kevinraymond93/Gesture-controlled-robotic-arm/docs/hardware_images/glove_below.png

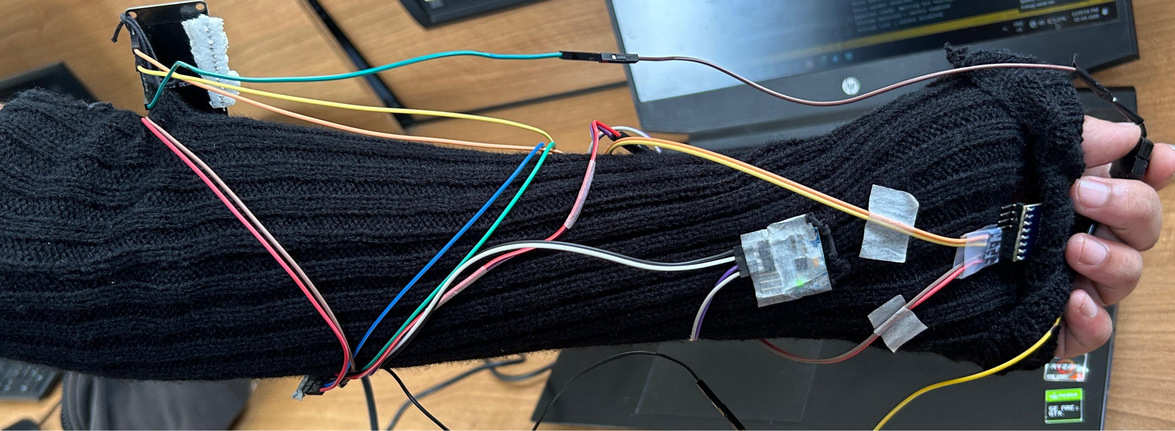
docs/hardware_images/glove_below.png
