kevinraymond93/Gesture-controlled-robotic-arm/docs/hardware_images/glove_top.png

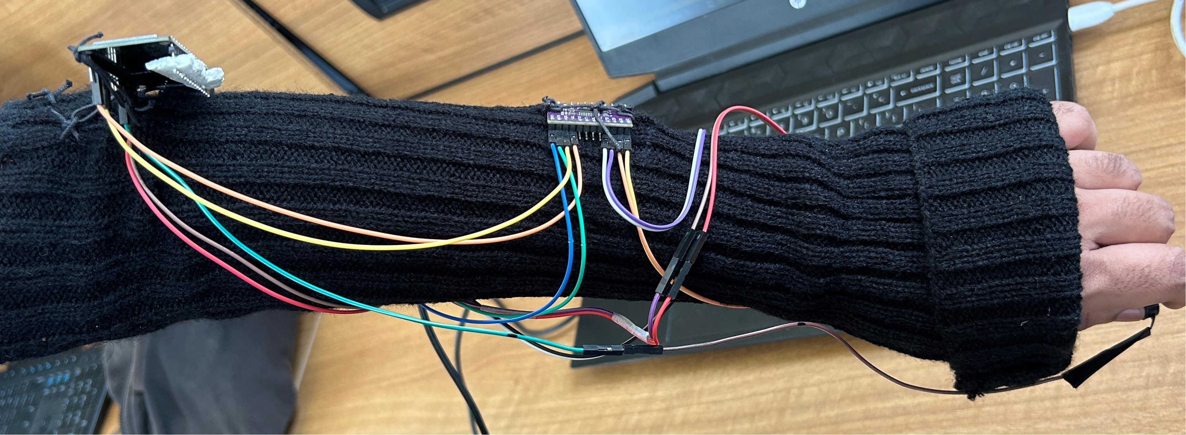
docs/hardware_images/glove_top.png
