kevinraymond93/Gesture-controlled-robotic-arm/docs/circuitry-diagram/receiver_ckt.png

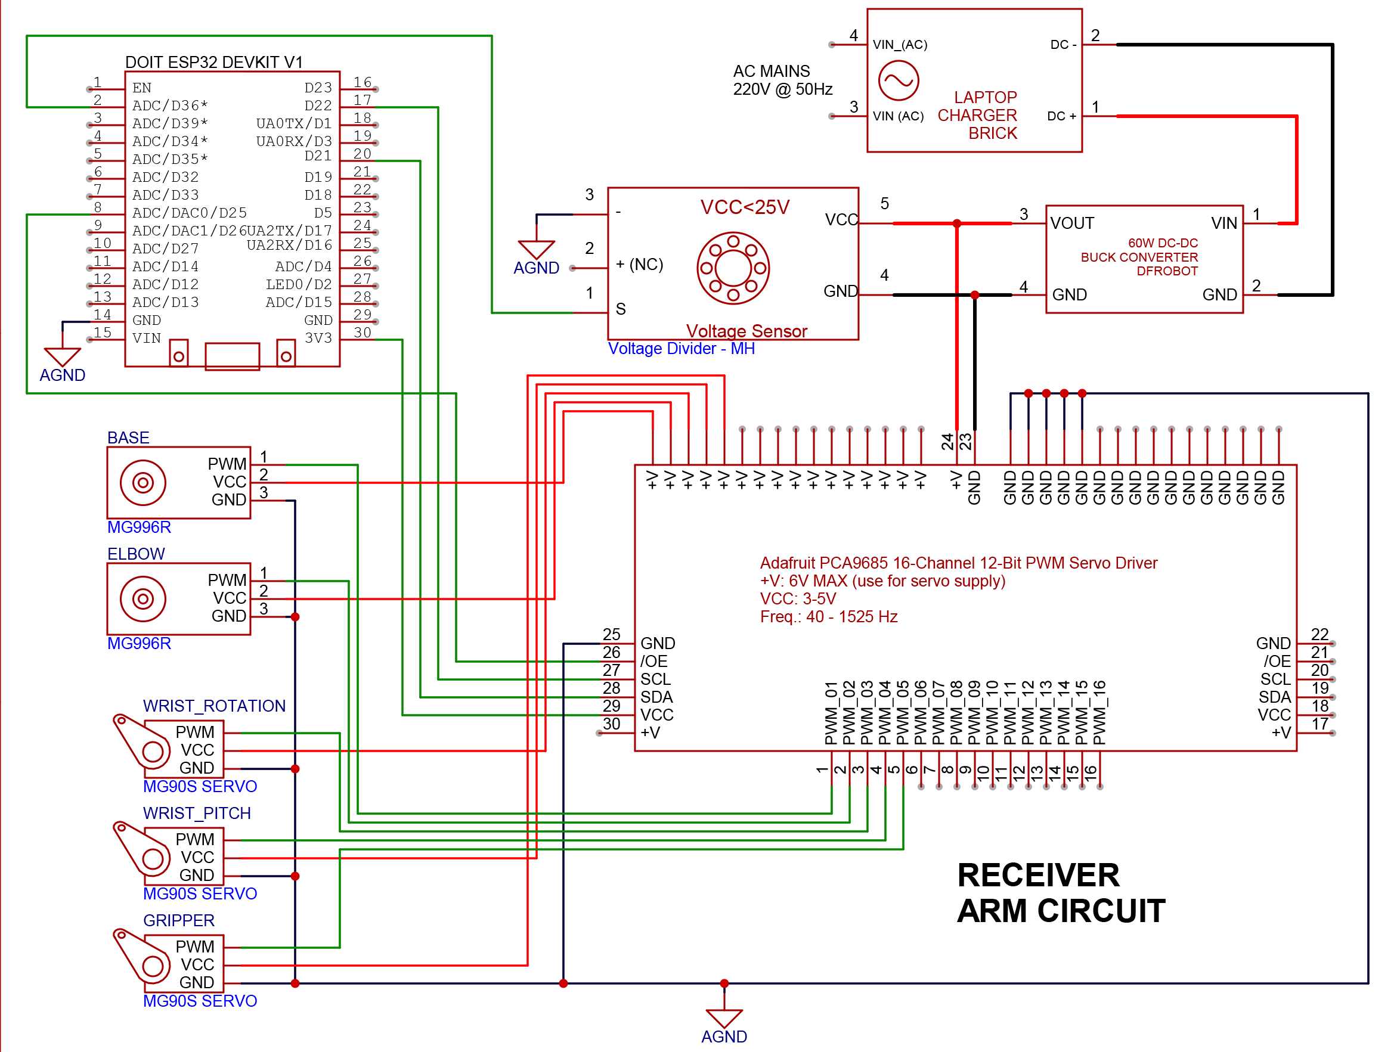
docs/circuitry-diagram/receiver_ckt.png
