kevinraymond93/Gesture-controlled-robotic-arm/docs/circuitry-diagram/transmitter_ckt.png

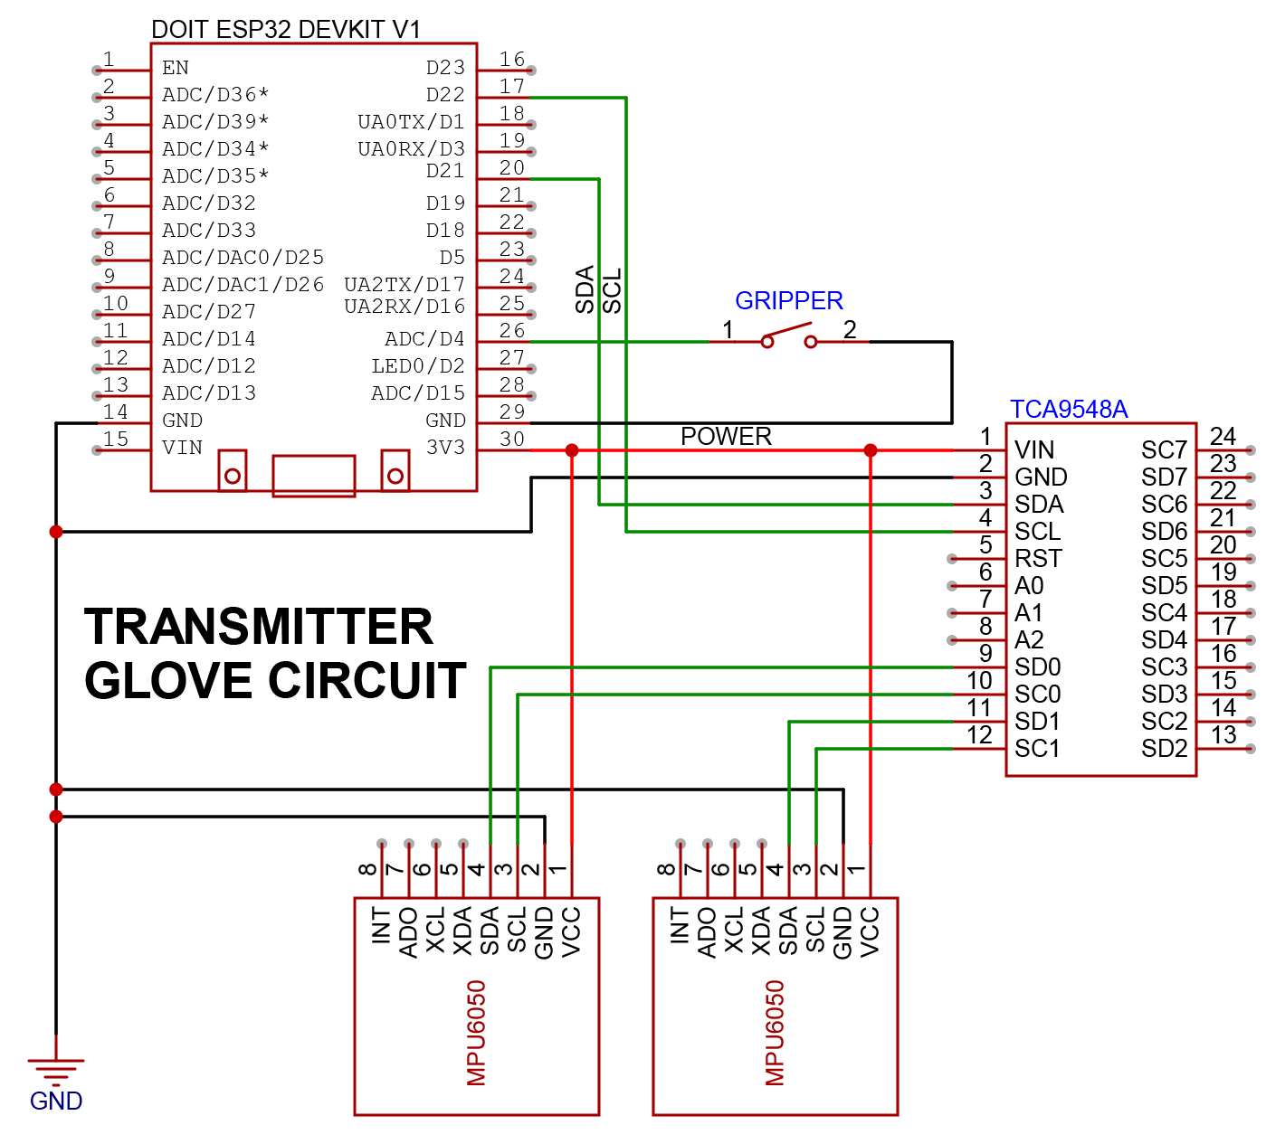
docs/circuitry-diagram/transmitter_ckt.png
