kevinraymond93/Gesture-controlled-robotic-arm/docs/flowcharts/receiver flow chart.png

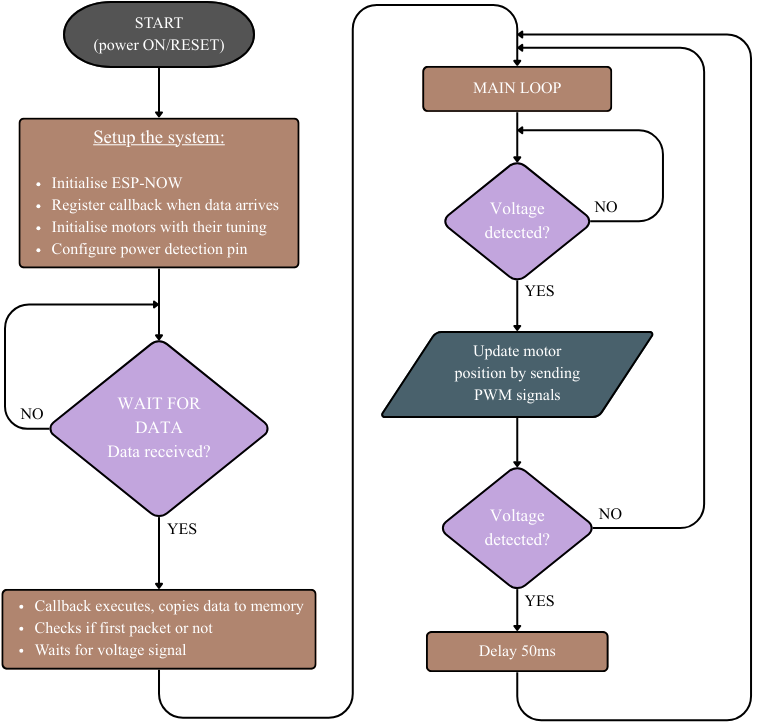
docs/flowcharts/receiver flow chart.png
