kevinraymond93/Gesture-controlled-robotic-arm/docs/flowcharts/transmitter flowchart.png

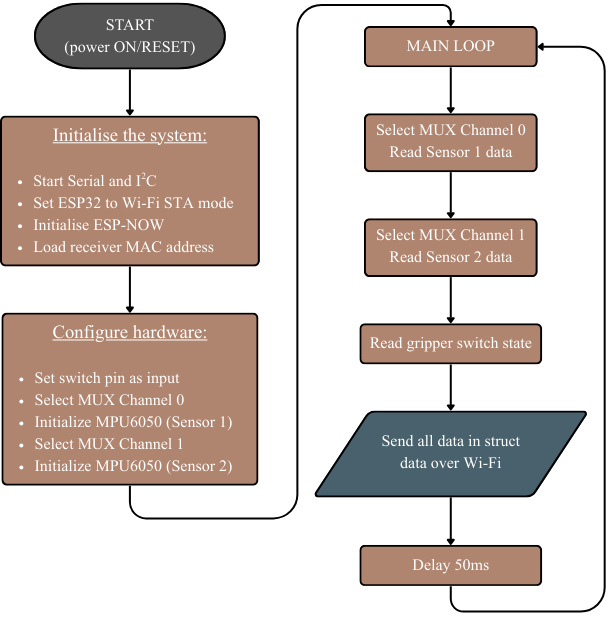
docs/flowcharts/transmitter flowchart.png
