kevinraymond93/Gesture-controlled-robotic-arm/docs/hardware_images/arm.png

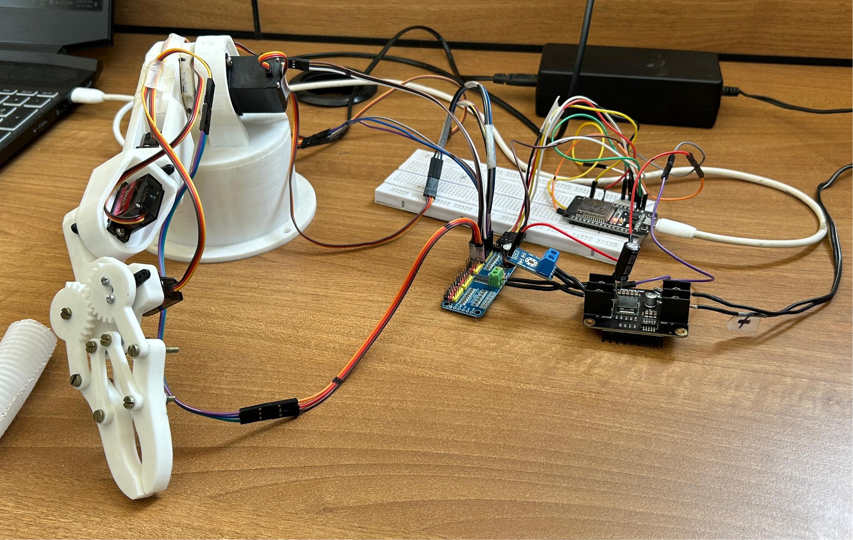
docs/hardware_images/arm.png
