kevinraymond93/Gesture-controlled-robotic-arm/(commit log)

2026-05-02 Rename firmware/receiver-arm/receiver flow chart.png to receiver flow chart.png
2026-05-02 Rename firmware/receiver-arm/transmitter flowchart.png to transmitter flowchart.png
2026-05-02 Rename receiver flow chart.png to docs/flowcharts/receiver flow chart.png
2026-05-02 Rename transmitter flowchart.png to docs/flowcharts/transmitter flowchart.png
